sudo-apt-install-tap/HEXAD/BOM.csv

Item | Qty | Supplier | Cost/item | Total Cost | link
Screen | 1 | ROBU.in | $8.50 | $8.50 | https://robu.in/product/waveshare-128x160-general-1-8-inch-lcd-display-module/
EC11 encoders | 6 | ROBU.in | $0.75 | $4.50 | https://robu.in/product/hongyan-ec11h-7ce20p1zy15f7-rotary-encoder-with-push-button-switch-vertical-plug-in-5-pin/
1N4148 Diodes | 20 | ROBU.in | $0.10 | $2.00 | https://robu.in/product/1n4148-tap-vishay-1n4148-tap-small-signal-diode-single-100-v-150-ma-1-v-8-ns-2-a/
100nf 50v Disc Capacitor | 10 | ROBU.in | $0.15 | $1.50 | https://robu.in/product/100nf-50v-disc-capacitor/
MCP23017-E/SS | 1 | ROBU.in | $3.50 | $3.50 | https://robu.in/product/mcp23017-e-ss-microchip-i-o-expander-16-bit-i2c-serial-1-8-v-5-5-v-ssop-28-pins/
2.54mm Headers | 4 | ROBU.in | $0.15 | $0.60 | https://robu.in/product/ph2-54-01-20pzd-xunpu-straight-policy-2-5mm-6mm-20p-40%e2%84%83105%e2%84%83-3mm-2-54mm-black-brass-single-row-1x20p-pluginp2-54mm-pin-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
IMG-20260925-WA0010 Blank Cherry Translucent Keycaps (1u) (Pack of 5) | 3 | MECKEYS | $1.50 | $4.50 | https://meckeys.com/shop/accessories/keyboard-accessories/keycaps/blank/blank-cherry-translucent-keycap-1u/
Gateron Milky PRO Switch – 5pin | 2 | MECKEYS | $2.25 | $4.50 | https://meckeys.com/shop/accessories/keyboard-accessories/key-switches/gateron-mechanical-pro-switch-5pin/
LuatOS USB C Raspberry PI PICO Development Board | 1 | MAKERBAZAR | $5.00 | $5.00 | https://makerbazar.in/products/luatos-usb-c-raspberry-pi-pico-development-board-based-on-rp2040-microcontroller
PCB | 1 | JLCPCB | $10.00 | $10.00 | https://jlcpcb.com/
Estimated total shipping | 1 |  |  | $4.40
