sudo-apt-install-tap/HEXAD/CAD/PCB.step

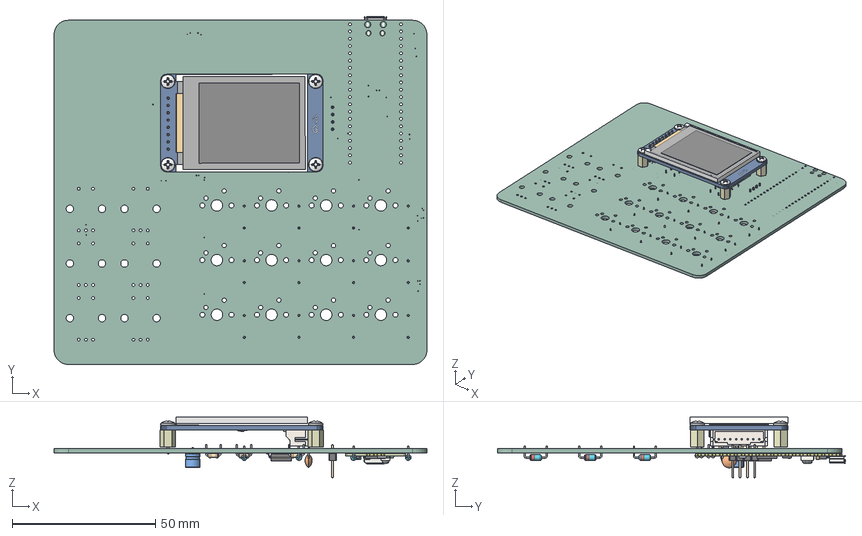
[picture p1: CAD file, 2026-10-24]
CAD/PCB.step
130.0 x 121.3 x 21.1 mm
LCD-TH_L56.5-W34.0_1-8INCH-LCD-MODULE
D_DO-35_SOD27_P7.62mm_Horizontal x 12
PinHeader_1x04_P254mm_Vertical
R_Axial_DIN0204_L36mm_D16mm_P508mm_Horizontal x 8
C_Disc_D50mm_W25mm_P500mm
RaspberryPi_Pico_Module_KiCad
CP_Radial_D50mm_P200mm
SOIC-28W_7.5x17.9mm_P1.27mm
PCB-unsaved-export-tWnPqS_PCB
