sudo-apt-install-tap/HEXAD/PCB/PCB.kicad_pcb

## KiCad design PCB/PCB.kicad_pcb (2026-10-24)

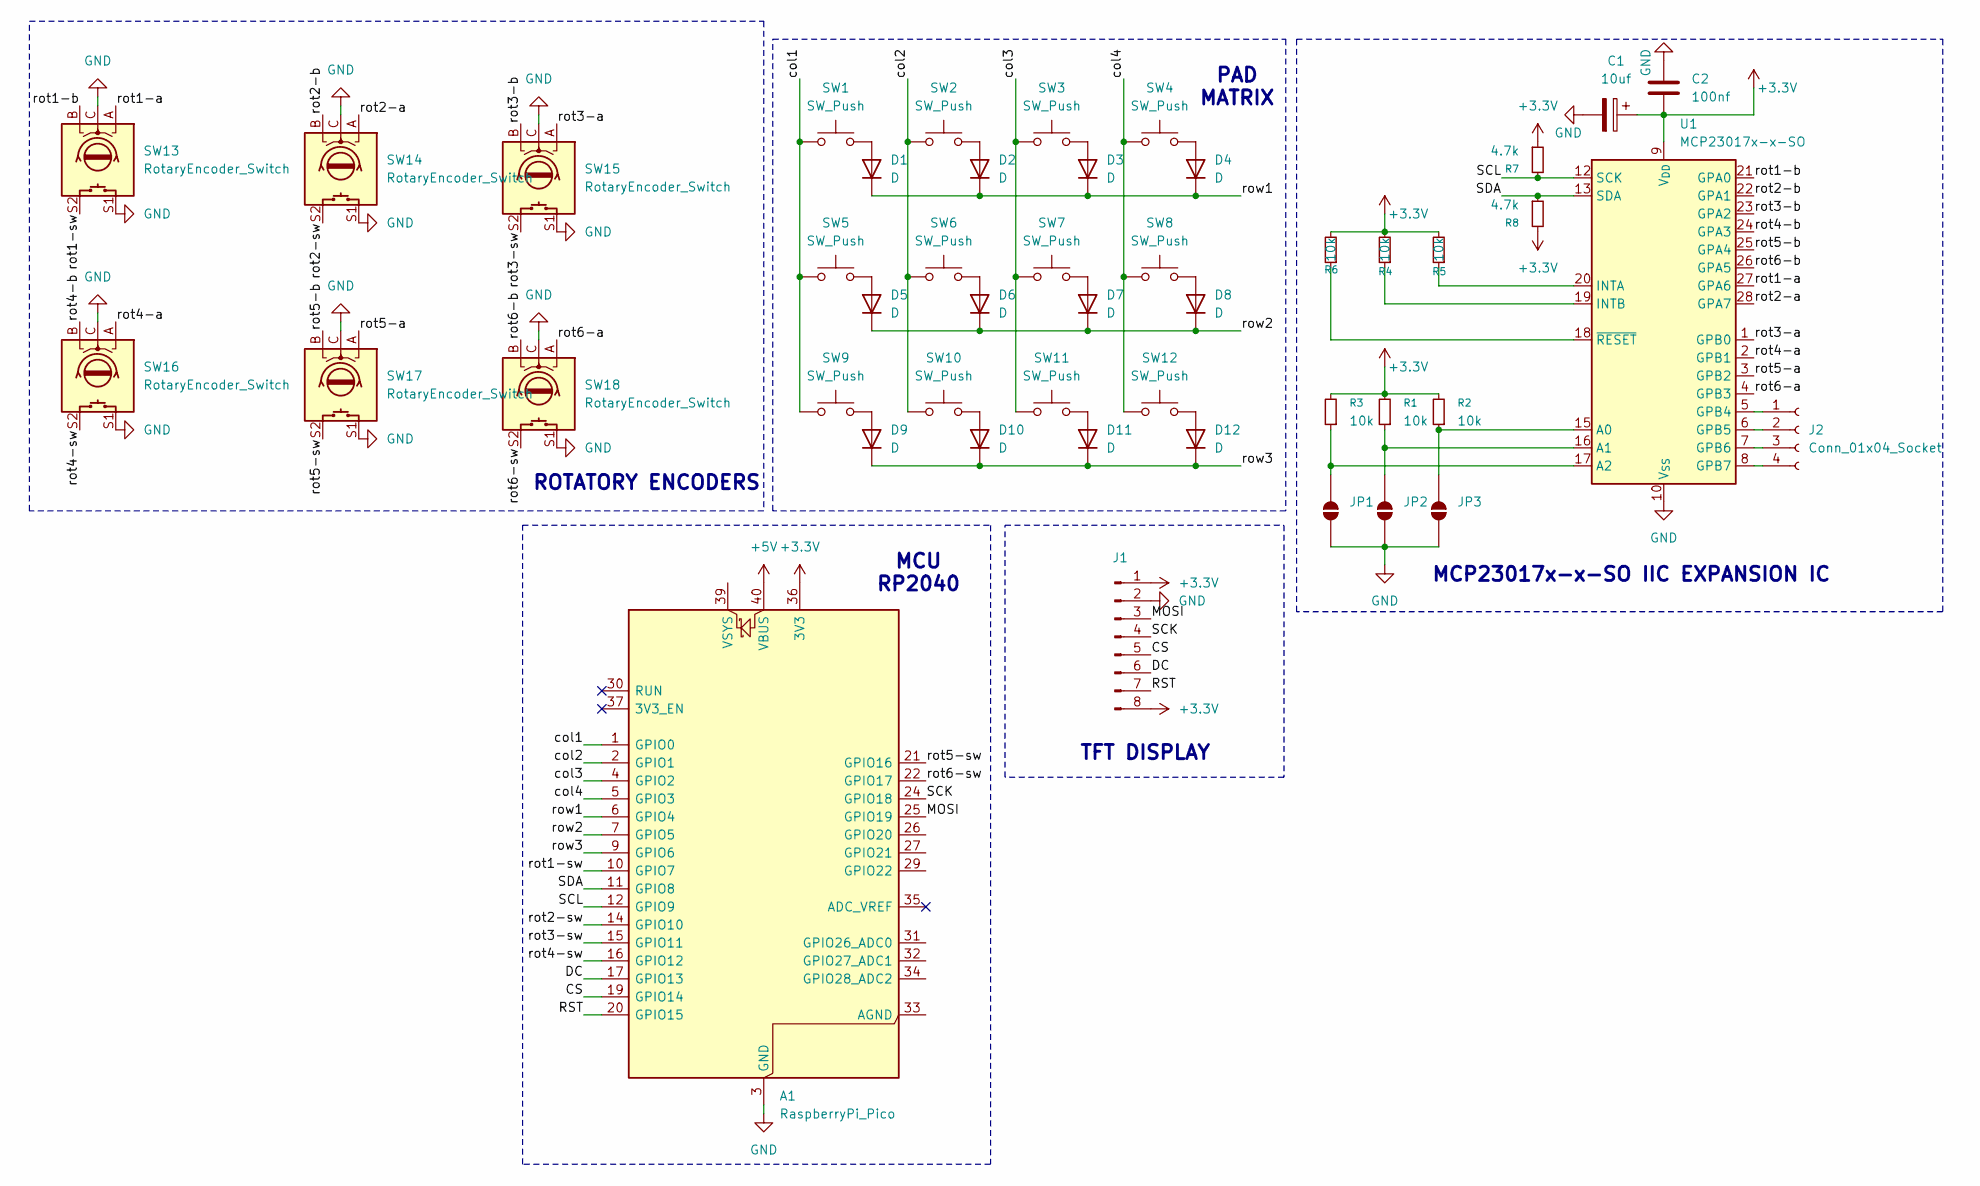
[picture p2: schematic PCB.kicad_sch, SCHEMATIC MIDI PAD V1]

Parts:
A1: RaspberryPi_Pico; RaspberryPi_Pico_Common_Unspecified
C1: 10uf; CP_Radial_D5.0mm_P2.00mm
C2: 100nf; C_Disc_D5.0mm_W2.5mm_P5.00mm
D1, D2, D3, D4, D5, D6, D7, D8, D9, D10, D11, D12: D; D_DO-35_SOD27_P7.62mm_Horizontal
J1: Conn_01x08_Pin; 1_8INCH_LCD_MODULE
J2: Conn_01x04_Socket; PinHeader_1x04_P2.54mm_Vertical
JP1, JP2, JP3: SolderJumper_2_Open; SolderJumper-2_P1.3mm_Open_RoundedPad1.0x1.5mm
R1, R2, R3, R4, R5, R6: 10k; R_Axial_DIN0204_L3.6mm_D1.6mm_P5.08mm_Horizontal
R7, R8: 4.7k; R_Axial_DIN0204_L3.6mm_D1.6mm_P5.08mm_Horizontal
SW1, SW2, SW3, SW4, SW5, SW6, SW7, SW8, SW9, SW10, SW11, SW12: SW_Push; SW_Cherry_MX_PCB_1.00u
SW13, SW14, SW15, SW16, SW17, SW18: RotaryEncoder_Switch; RotaryEncoder_Alps_EC11E-Switch_Vertical_H20mm_CircularMoun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
U1: MCP23017x-x-SO; SOIC-28W_7.5x17.9mm_P1.27mm

Connections:
+3.3V: A1.36 (3V3), C1.1, C2.2, J1.1, J1.8, R1.2, R2.2, R3.2, R4.2, R5.2, R6.2, R7.1, R8.2, U1.9 (V_{DD})
+5V: A1.40 (VBUS)
/CS: A1.19 (GPIO14), J1.5
/DC: A1.17 (GPIO13), J1.6
/MOSI: A1.25 (GPIO19), J1.3
/RST: A1.20 (GPIO15), J1.7
/SCK: A1.24 (GPIO18), J1.4
/SCL: A1.12 (GPIO9), R7.2, U1.12 (SCK)
/SDA: A1.11 (GPIO8), R8.1, U1.13 (SDA)
/col1: A1.1 (GPIO0), SW1.1, SW5.1, SW9.1
/col2: A1.2 (GPIO1), SW2.1, SW6.1, SW10.1
/col3: A1.4 (GPIO2), SW3.1, SW7.1, SW11.1
/col4: A1.5 (GPIO3), SW4.1, SW8.1, SW12.1
/rot1-a: SW13.A, U1.27 (GPA6)
/rot1-b: SW13.B, U1.21 (GPA0)
/rot1-sw: A1.10 (GPIO7), SW13.S2
/rot2-a: SW14.A, U1.28 (GPA7)
/rot2-b: SW14.B, U1.22 (GPA1)
/rot2-sw: A1.14 (GPIO10), SW14.S2
/rot3-a: SW15.A, U1.1 (GPB0)
/rot3-b: SW15.B, U1.23 (GPA2)
/rot3-sw: A1.15 (GPIO11), SW15.S2
/rot4-a: SW16.A, U1.2 (GPB1)
/rot4-b: SW16.B, U1.24 (GPA3)
/rot4-sw: A1.16 (GPIO12), SW16.S2
/rot5-a: SW17.A, U1.3 (GPB2)
/rot5-b: SW17.B, U1.25 (GPA4)
/rot5-sw: A1.21 (GPIO16), SW17.S2
/rot6-a: SW18.A, U1.4 (GPB3)
/rot6-b: SW18.B, U1.26 (GPA5)
/rot6-sw: A1.22 (GPIO17), SW18.S2
/row1: A1.6 (GPIO4), D1.1 (K), D2.1 (K), D3.1 (K), D4.1 (K)
/row2: A1.7 (GPIO5), D5.1 (K), D6.1 (K), D7.1 (K), D8.1 (K)
/row3: A1.9 (GPIO6), D9.1 (K), D10.1 (K), D11.1 (K), D12.1 (K)
GND: A1.3 (GND), A1.8 (GND), A1.13 (GND), A1.18 (GND), A1.23 (GND), A1.28 (GND), A1.38 (GND), C1.2, C2.1, J1.2, JP1.1 (A), JP2.1 (A), JP3.1 (A), SW13.C, SW13.S1, SW14.C, SW14.S1, SW15.C, SW15.S1, SW16.C, SW16.S1, SW17.C, SW17.S1, SW18.C, SW18.S1, U1.10 (V_{SS})
unnamed: D1.2 (A), SW1.2
unnamed: D2.2 (A), SW2.2
unnamed: D3.2 (A), SW3.2
unnamed: D4.2 (A), SW4.2
unnamed: D5.2 (A), SW5.2
unnamed: D6.2 (A), SW6.2
unnamed: D7.2 (A), SW7.2
unnamed: D8.2 (A), SW8.2
unnamed: D9.2 (A), SW9.2
unnamed: D10.2 (A), SW10.2
unnamed: D11.2 (A), SW11.2
unnamed: D12.2 (A), SW12.2
unnamed: J2.1, U1.5 (GPB4)
unnamed: J2.2, U1.6 (GPB5)
unnamed: J2.3, U1.7 (GPB6)
unnamed: J2.4, U1.8 (GPB7)
unnamed: JP1.2 (B), R3.1, U1.17 (A2)
unnamed: JP2.2 (B), R1.1, U1.16 (A1)
unnamed: JP3.2 (B), R2.1, U1.15 (A0)
unnamed: R5.1, U1.20 (INTA)
unnamed: R4.1, U1.19 (INTB)
unnamed: R6.1, U1.18 (~RESET)

Notes on the sheet:
MCU RP2040
ROTATORY ENCODERS
PAD MATRIX
TFT DISPLAY
MCP23017x-x-SO IIC EXPANSION IC

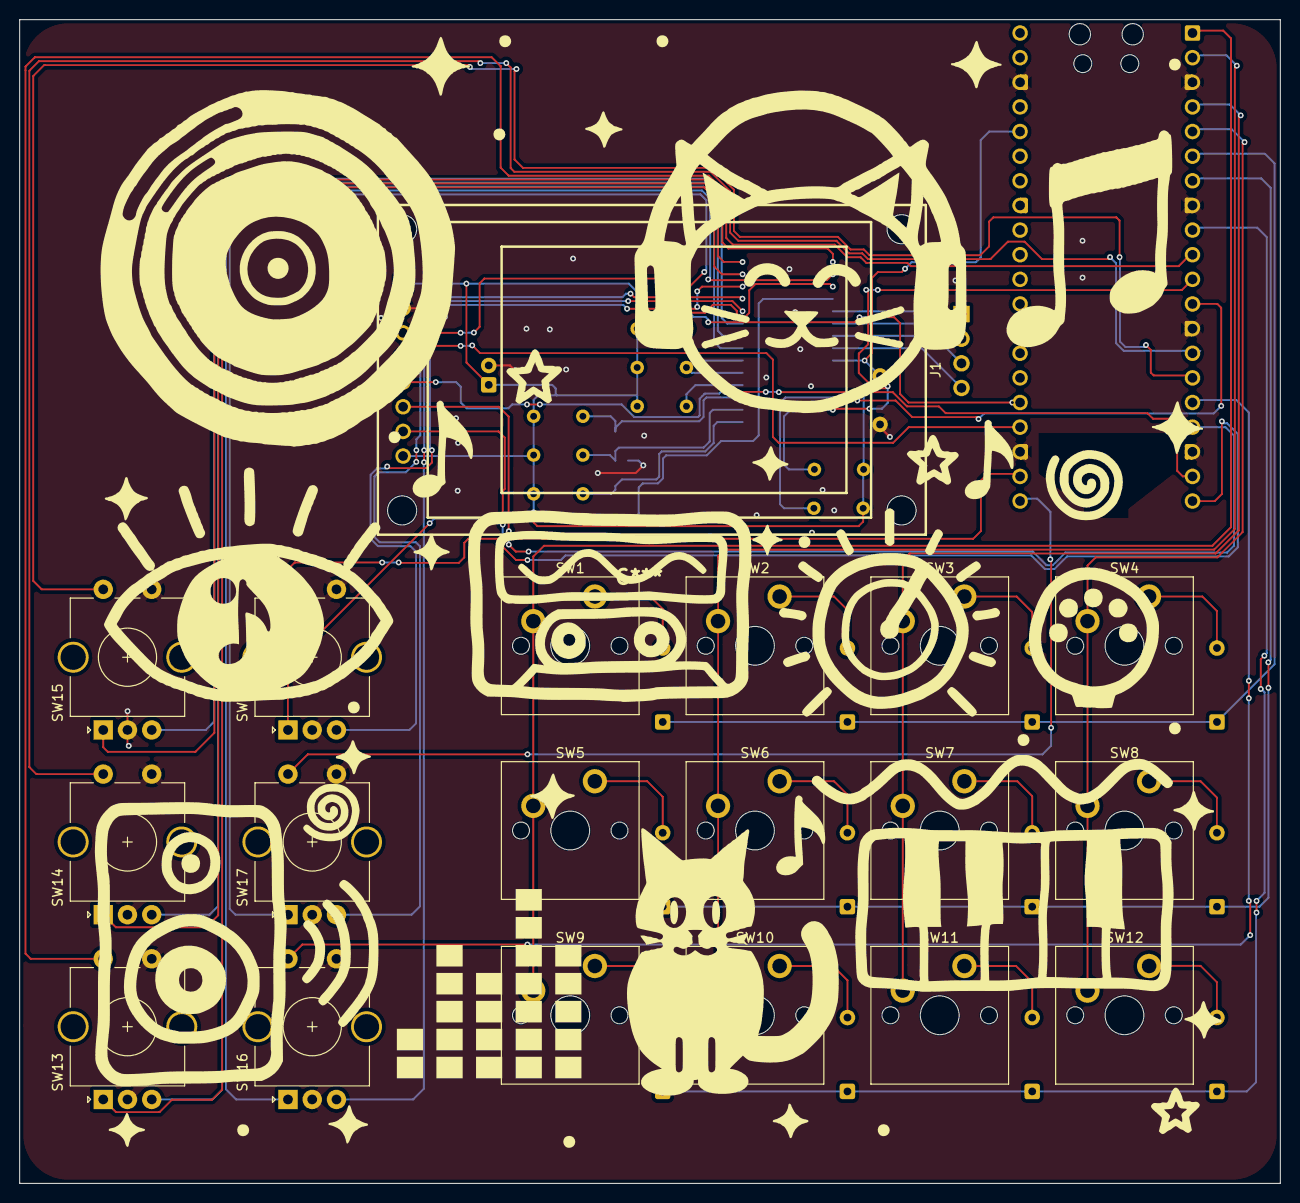
[picture p3: board PCB.kicad_pcb from above]

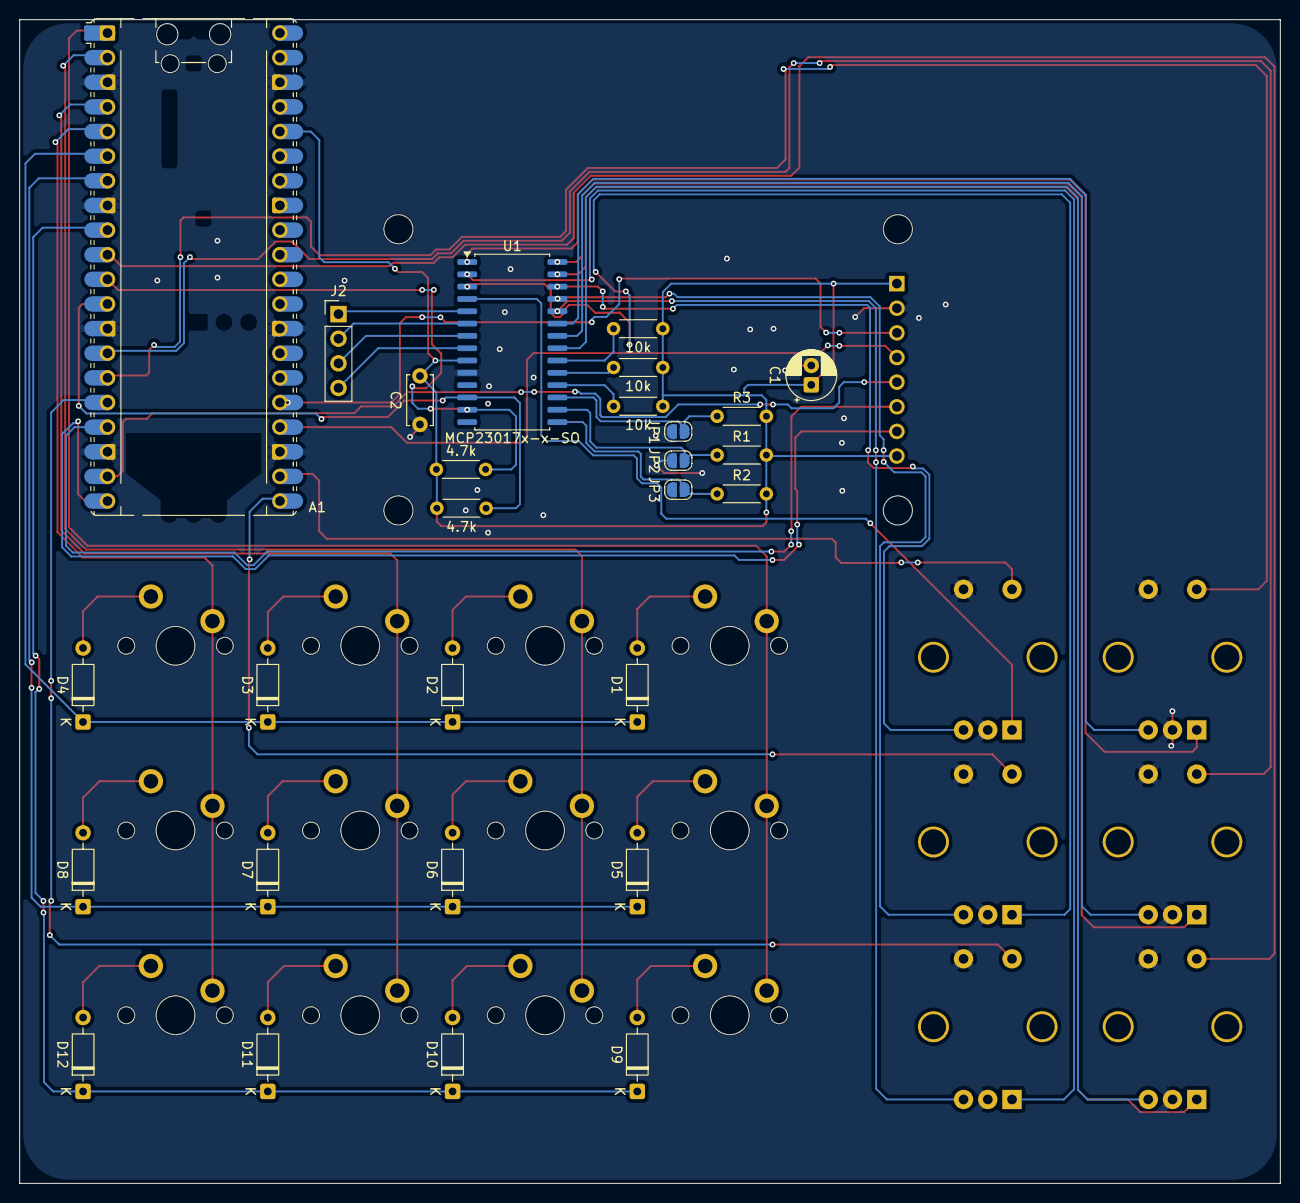
[picture p4: board PCB.kicad_pcb from below]

Board: 2 copper layers, 130.0 x 120.0 mm, 47 parts (28 on the bottom side), 56 nets.
