sudo-apt-install-tap/HEXAD/JOURNAL.md

# HEXAD – devlog

<!-- Generated by Half Life from project cmvesq2p20a1r01rcws8h5vj6. Edits here are overwritten on the next sync. -->
<!-- Generated: 2026-10-24T15:37:33.637Z -->

> [!NOTE]
> This devlog is mirrored from [Half Life](https://halflife.hackclub.com) – [open the project](https://halflife.hackclub.com/projects/cmvesq2p20a1r01rcws8h5vj6). Editing it here will not change the platform's copy, and the next sync overwrites this file.

> A MIDI pad for beginners. Uses mx keys, EC11 rotary encoder, 1.8" TFT display. Its not supposed to be something crazy professional, just a fun toy!

| Week | Tier | Hours logged | Entries |
| --- | --- | --- | --- |
| Week 3 | Tier 2 | 20h | 5 |

## Contents

1. [2026-10-22 – # Started  Working on the  MIDI pad!](#2026-10-22-started-working-on-the-midi-pad)
2. [2026-10-22 – # Checked the schematic.](#2026-10-22-checked-the-schematic)
3. [2026-10-23 – # PCB DESIGN!](#2026-10-23-pcb-design)
4. [2026-10-24 – # PCB FINALIZED](#2026-10-24-pcb-finalized)
5. [2026-10-24 – # The finish line.](#2026-10-24-the-finish-line)

## Design

### 2026-10-22 – # Started  Working on the  MIDI pad!

**3.5h**

# Started  Working on the  MIDI pad!

## N.T: This devlog is from the work done on Monday 19/10/26.

## Journal log

So today I started working on the midi pad! I have a few design requirements in my mind. Here are all of them in descending order of priority:

1. USB C
2. RP2040 based.
3. 4x3 switch matrix using standard mechanical switches.
4. TFT display 1.8"
5. EC-11 rotary encoders
6. Debug and extra GPIO pin headers.

Eventually while wiring everything I ran out of GPIO pins that I could use.  This led to me finally needing to use a I2C I/O expander, I chose the [MCP23017x-x-SO I2C EXPANSION IC](https://www.ktron.in/product/mcp23017t-e-so-16-bit-i-o-expander).  I connected the rotary encoder pins A and B to this because timing isn't really as important for them compared to the keys which require the least latency as possible.This was
my choice due to a few reasons.

1. It doesn't require that many passives or decoupling capacitors compared to alternatives.
2. It is pretty easy to source.
3. Claude recommended it. This was cross examined by the datasheet.
4. It can be soldered by hand.

Anyway, let me show you my schematic


Rotary Encoders


Switch Matrix


I/O Expansion IC


RPi Pico, and TFT headers.

## What's next?

I need to cross check my design with Claude and the datasheets for the IC and assign footprints to all the components.

### 2026-10-22 – # Checked the schematic.

**2.5h**

# Checked the schematic.

## N.T: Like the previous journal this too is backdated to 20/10/26 to 21/10/26

##  Schematic sanity checking

I followed though with Claude's advice and added external pull up resistors on the I2C communication lines namely, SCL and SDA. Then I had to assign footprints to all the components. Also i used a 100nf decoupling capacitor on the I/O expansion IC.

Here are the images!







### 2026-10-23 – # PCB DESIGN!

**5h**

# PCB DESIGN!

## Includes work done on 22/10/26 and 23/10/26

I started the PCB layout and routing.

I had to change the pinout for the display module as i am using a more documented one now, the [Waveshare 128x160 General 1.8 Inch LCD Display Module](https://robu.in/product/waveshare-128x160-general-1-8-inch-lcd-display-module/).

I used a plugin to import the jlcpcb library footprint for this module.

Heres the new pin out



Also I did the full layout for the project for now, and worked on some of the routing, and finished the matrix routing.

Here are a few images from this session.









### 2026-10-24 – # PCB FINALIZED

**5h**

# PCB FINALIZED

## N.T: This journal isn't backdated! Reviewers might rejoice.

So, I finished the routing for then entire PCB, rather the routing process finished me. It was long and tedious and was a path filled with many a vias, but I finished it, just in the nick of time. Then came the DRC. [insert scared cat]

WELL you know what? it wasn't that bad, it might have been bad if i was new to PCB design, but i am not an amateur. Just a few unconnected ground pours and a few track clearance issues, which to be honest, wasn't all that hard to fix. Well now we are in the last few hours of the project

##  Whats next?

- FIRMWARE, this is a big one
- Repo making and writing the readme.md

About the case now, i wont be doing any cad for this week as I am tired of onshape from the past weeks project and want atleast one week off from CAD.

## Images











### 2026-10-24 – # The finish line.

**4h**

# The finish line.

I completed the project!

I did all of the artwork on the pcb, the firmware, and the repo readme. I got some artwork from claude to use on the front side of the pcb, i gathered the inspo and also wrote the prompt. I read through some documentation and wrote the firmware in Arduino IDE with Pico core and tiny usb midi, along side some more essential imports.

Here is the silkscreen art

music_doodles_silkscreen





Also heres the repo
