sudo-apt-install-tap/HEXAD/(commit log)

2026-10-24 Enhance README with project details and visuals
    Updated README to include detailed project overview, MIDI mapping, pin mapping, CAD files, and images.
2026-10-24 added CAD/PCB.step
2026-10-24 Remove case requirement note from README
    Removed the note about not needing a case or 3D print.
2026-10-24 Fix link formatting for CAD files in README
2026-10-24 Clean up README.md by removing BOM section
    Remove unnecessary BOM section and closing div tag.
2026-10-24 added gerbers
